ConstellationKev/MDG/firmware_base/image.jpg

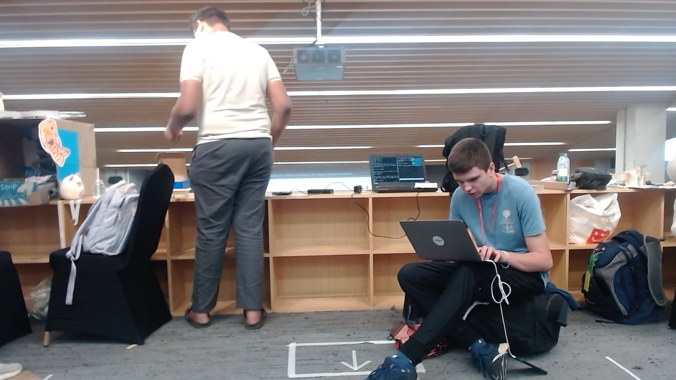
firmware_base/image.jpg
