ConstellationKev/MDG/BOM/BOM.csv

Material | Qty | Units | Buying Link (Accounts for quantity) | Cost (Accounts for shipping) | Notes
ESP32-S3 N16R8 Dev Board | 2 | Each | https://www.amazon.com/Hosyond-Development-Dual-Mode-Compatible-ESP32-S3-WROOM-1/dp/B0F5QCK6X5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 | $18.99
Quadruple AA Battery Pack 6V | 1 | Each | https://www.amazon.com/VWEICYY-Battery-Holder-housing-Leads/dp/B0DZWK2TNY?sp_csd=d2lkZ2V0TmFtZT1zcF9hdGY | $6.99
DRV8833 Motor Driver | 1 | Each | https://www.amazon.com/dp/B07S7Z8CFL/ref=twister_B07S5J1HGP?_encoding=UTF8&th=1 | $5.99
16-Channel 12-bit PWM/Servo Driver - PCA9685 | 2 | Each | https://www.microcenter.com/product/613661/adafruit-industries-16-channel-12-bit-pwm-servo-driver | $29.90
20 AWG Silicone Hookup Wires (2 Colors) | 1 | Wires | https://www.amazon.com/Silicone-Electrical-Core-Flexible-Strands/dp/B0B9JCXN9M/ | $5.88
Female DC Power adapter - 2.1mm jack to screw terminal block | 1 | Each | https://www.amazon.com/ALITOVE-100-240V-Replacement-Security-Raspberry/dp/B0BVHQKNS6/ | $9.99
5V 2A (2000mA) switching power supply - UL Listed | 1 | Each | Same as above ^ | $0.00 | Included in above price
Female DC Barrel Jack | 1 | Each | https://www.amazon.com/California-JOS-Breadboard-Friendly-Mounting-Female/dp/B09ZBN38FS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 | $6.99
Low Profile Servo | 1 | Servos | https://www.amazon.com/Deegoo-FPV-Servo-MG995-Metal-Gear/dp/B0D7M3BBL2 | $13.98
ES08MAII E-MAX Analog Micro Servo | 4 | Servos | https://www.amazon.com/dp/B07KYK9N1G?lv=shuf&channelId=500&plpRedirect=mhFallback&th=1 | $39.99 | Expensive or cheap both works; use cheap to save money. Also we got this at HJB and it was SO MUCH CHEAPER (10RMB each compared to 10USD each)
M2.5 Screws + Nuts Kit | 1 | Each | https://www.amazon.com/binifiMux-280pcs-Button-Socket-Assortment/dp/B09CPDVYB7/ | $9.99
M2 Screws + Nuts Kit | 1 | Each | https://www.amazon.com/QOOSIKICC-Assortment-Socket-Washers-Machine/dp/B0DDXZH9L2/ | $7.58
M4 Screws + Nuts Kit | 1 | Each | https://www.amazon.com/Machine-Screws-Countersunk-Phillips-Assortment/dp/B0CCPJTVL1 | $6.48
Soldering Kit | 1 | Each | https://www.amazon.com/Soldering-soldering-solder-adjustable-temperature/dp/B09DY7CCW5/ | $9.99
Jumper Wires Assortment | 1 | Each | https://www.amazon.com/Elegoo-EL-CP-004-Multicolored-Breadboard-arduino/dp/B01EV70C78 | $6.98 | Self-sourced, I already own this so I don't need extra funding for this.
AMS1117 Voltage Regulator | 1 | Each | https://www.amazon.com/VKLSVAN-AMS1117-3-3V-Converter-Voltage-Regulator/dp/B0DPMQXWMS?nsdOptOutParam=true | $5.96
GA25Y-370 Motor-47.9 | 1 | Each | https://www.amazon.com/25GA-370-Reduction-Geared-Electronic-400RPM/dp/B07JGWXSHF | $12.43 | Or any webcam of your choice, labtop/compiter webcam also works
Logitech C920 Webcam | 1 | Each | https://www.amazon.com/Logitech-Widescreen-Calling-Recording-Desktop/dp/B006JH8T3S | $68.00
TM1637 4-Digit Display | 1 | Each | https://www.amazon.com/DIYables-4-Digit-7-Segment-Display-Raspberry/dp/B0BXKLZJMV | $5.99
Cardboard | 1 | Board | N/A | $0.00
Hot Glue Kit | 1 | Each | https://www.amazon.com/Krightlink-Sticks-School-Crafts-Repairs/dp/B0BC878ZRG | $8.99
Limit Switches | 2 | Each | https://www.amazon.com/HiLetgo-KW12-3-Roller-Switch-Normally/dp/B07X142VGC | $5.99
Magnets 6mm | 2 | Pairs | https://www.amazon.com/Magnets-Refrigerator-Cylinder-Whiteboard-Miniature/dp/B0936M3WPK | $4.99
Foam | 1 | Block | N/A | $0.00
Rack and Pinion 3D Part | 1 | Each | N/A | $0.02
Obstacles 3D Part | 4 | Each | N/A | $0.47
Motor Mount 3D Part | 1 | Each | N/A | $0.77
Dinosaur 3D Part | 1 | Each | N/A | $0.13
AA Batteries | 4 | Each | amazon.com/AmazonBasics-Performance-Alkaline-Batteries-8-Pack/dp/B00O869KJE/ref=sr_1_3?crid=21ZB6L8Y1KM0Q&dib=eyJ2IjoiMSJ9.qezp8kXthZdyOBn254AAdiHAMmzXcHLZXWFYbgOx69AsDOUuSlgEUCvC4RzXWH5pQL8X_oJBTllFXSrfwQ7rw9NtlTY5eaAw37qBd06A8L5TseoImHSYmPRshfoVNVHUZAKYJ5a7R2QoNg42nsfvws1XVmeLXh5D-VpWx6-6GZwQKfoSbI8UcDbxxxdEjErTgjrtv4kW8xBEbacESqa2y5I4J9XRK2lRNKYTnBcUT4an80o3jUrB-QKVBCfdaEjHsmL5InILFzfC9juOh9kNUUAl3002ga5K2L38MbX2hn4.mP9y-W-w3PzfKWmnAqugdhXhgWxFmitU8cyaP9EEUgU&dib_tag=se&keywords=AA+batteries&qid=1783315609&rdc=1&sprefix=aa+batter%2Caps%2C414&sr=8-3 | $6.49
Taxes (in Fremont, California) | N/A | N/A | N/A | $28.51 | I don't need extra funding for this, I can pay this.
 |  |  | Total Cost: | $328.46
 |  |  | Note: Everything is bought with Amazon and Microcenter which has free shipping
