ConstellationKev/MDG/zine.pdf

# dINOJUMP

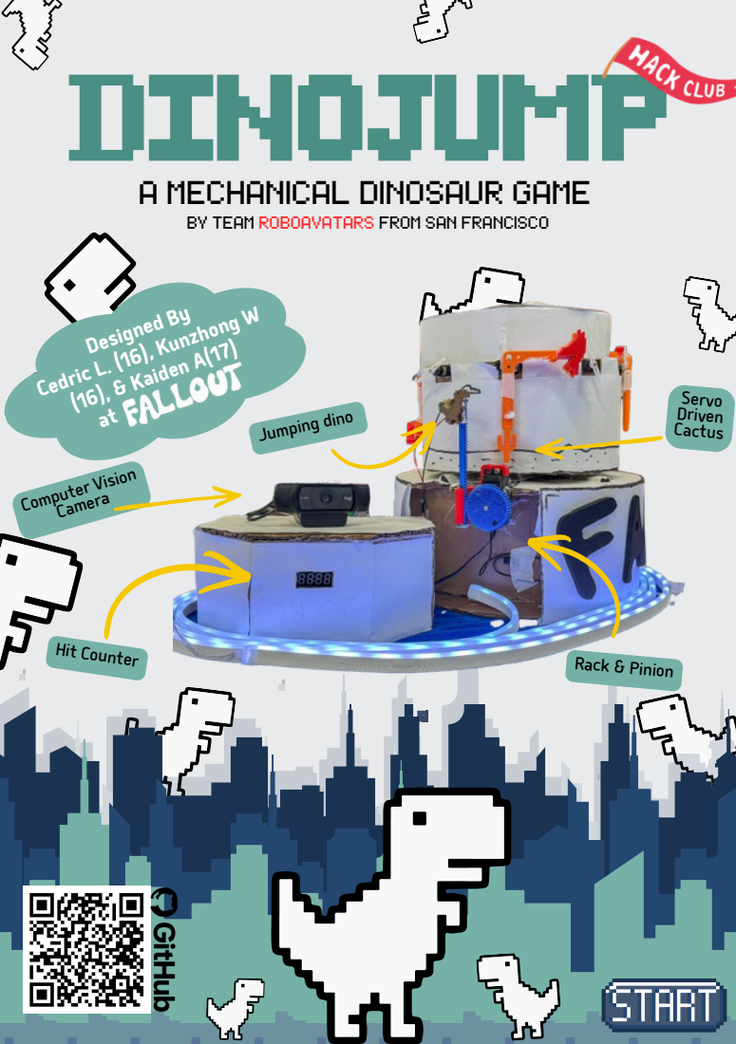
[picture p7: page 1]
Jumping dino; Hit Counter; Computer Vision Camera; Designed By Cedric L. (16), Kunzhong W (16), & Kaiden A(17); Rack & Pinion; Servo Driven Cactus

A MECHANICAL DINOSAUR GAME

BY TEAM ROBOAVATARS FROM SAN FRANCISCO
